henryhallam/quickie-battpacks/bms_v1_bom.xlsx

Reference Designator | Quantity | Description/Value | Manufacturer Part Number (MPN)
REF**,REF**,REF**,REF**,REF**,REF**,REF** | 7 | Fiducials | DNP
C501,C301,C401,C601,C701,C801,C901,C1001,C1101,C1201,C1301,C1401,C201,C1501,C1601,C1701,C1801,C1901,C2001,C2101,C2201,C2301,C2401,C2501,C2601,C2701 | 26 | CAP CER 0.01uF 50V | GCM155R71H103KA55D
C202,C205,C208,C1502,C1505,C1508 | 6 | CAP CER 1uF 16V | GCM188R71C105KA64D
C203,C204,C1503,C1504 | 4 | CAP CER 0.1uF 250V | CGA4J3X7T2E104M125AE
J201,J202,J1501,J1502 | 4 | Conn Picoblade 2pos | 53261-0271
Q201,Q1501 | 2 | Transistor NPN | NSV1C201MZ4
Q301,Q401,Q501,Q601,Q701,Q801,Q901,Q1001,Q1101,Q1201,Q1301,Q1401,Q1601,Q1701,Q1801,Q1901,Q2001,Q2101,Q2201,Q2301,Q2401,Q2501,Q2601,Q2701 | 24 | MOSFET P-CH 3A | DMP3130LQ
R202,R203,R1502,R1503 | 4 | RES 100R 1% | ERJ-3EKF1000V
R205,R206,R1505,R1506 | 4 | RES 120R 1% | ERJ-3EKF1200V
R301,R401,R501,R601,R701,R801,R901,R1001,R1101,R1201,R1301,R1401,R1601,R1701,R1801,R1901,R2001,R2101,R2201,R2301,R2401,R2501,R2601,R2701 | 24 | RES 10R 5% 3W | 352210RJT
T201,T1501 | 2 | Transformer pulse | HX0068ANL
U201,U1501 | 2 | IC MONITOR BATT STACK | LTC6804HG-1
P201,P301,P401,P501,P601,P701,P801,P901,P1001,P1101,P1201,P1301,P1401,P1501,P1601,P1701,P1801,P1901,P2001,P2101,P2201,P2301,P2401,P2501,P2601,P2701 | 26 | Solder point | DNP
C206,C207,C1506,C1507 | 4 | CAP CER 100pF 50V | CGJ2B2C0G1H101J050BA
R204,R1504 | 2 | RES 1.2K 1% | ERJ-2RKF1201X
R207,R208,R210,R211,R212,R213,R214,R1507,R1508,R1510,R1511,R1512,R1513,R1514 | 14 | RES 10K 0.1% | ERA-2AEB103X
R302,R402,R502,R602,R702,R802,R902,R1002,R1102,R1202,R1302,R1402,R201,R1501,R1602,R1702,R1802,R1902,R2002,R2102,R2202,R2302,R2402,R2502,R2602,R2702 | 26 | RES 100R 1% | ERJ-2RKF1000X
R209,R303,R403,R503,R603,R703,R803,R903,R1003,R1103,R1203,R1303,R1403,R1509,R1603,R1703,R1803,R1903,R2003,R2103,R2203,R2303,R2403,R2503,R2603,R2703 | 24 | RES 2.8K 1% | ERJ-2RKF2801X
D201,D1501 | 2 | DIODE GEN PURP SOD523 | 1N4148X
LED201,LED202,LED1501,LED1502 | 4 | LED 0402 YEL/GRN | SML-P12MTT86R
TH201,TH202,TH203,TH204,TH205,TH1501,TH1502,TH1503,TH1504,TH1505 | 10 | Thermistors | DNP
