henryhallam/quickie-battpacks/bms.kicad_pcb

## KiCad design bms.kicad_pcb (2017-09-25)

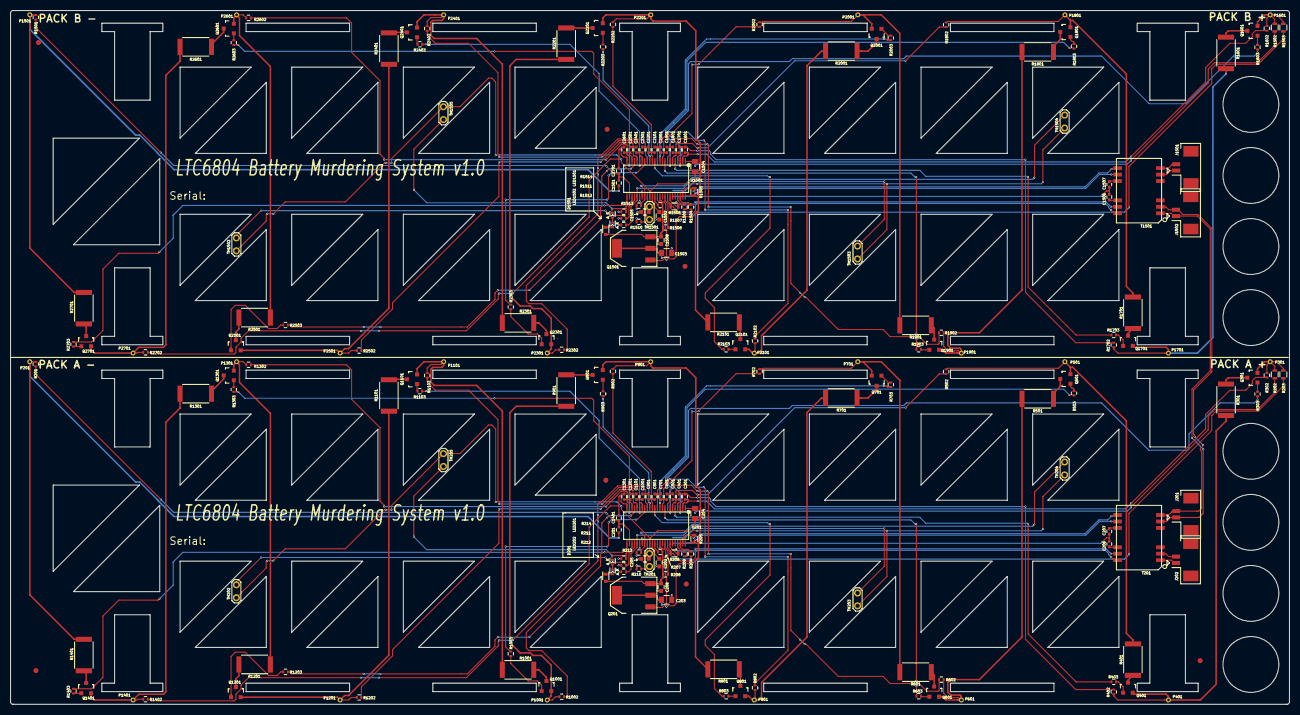
[picture p1: board bms.kicad_pcb from above]

Board: 2 copper layers, 252.0 x 136.7 mm, 216 parts (0 on the bottom side), 176 nets.

Parts:
C201, C301, C401, C501, C601, C701, C801, C901, C1001, C1101, C1201, C1301, C1401, C1501, C1601, C1701, C1801, C1901, C2001, C2101, C2201, C2301, C2401, C2501, C2601, C2701: 10nF 16V; C_0402
C202, C205, C208, C1502, C1505, C1508: 1uF 16V; C_0603
C203, C204, C1503, C1504: 0.1uF 100V; C_0805
C206, C207, C1506, C1507: 100pF; C_0402
D201, D1501: 1N4148X; SOD-523
J201, J202, J1501, J1502: CONN_01X02; Molex_PicoBlade_53261-0271
LED201, LED202, LED1501, LED1502: SML-P12MTT86R; LED_0402
P201, P301, P401, P501, P601, P701, P801, P901, P1001, P1101, P1201, P1301, P1401, P1501, P1601, P1701, P1801, P1901, P2001, P2101, P2201, P2301, P2401, P2501, P2601, P2701: CONN_01X01; Solder_Point_Round-TH_0.5mm
Q201, Q1501: NSV1C201MZ4; SOT-223
Q301, Q401, Q501, Q601, Q701, Q801, Q901, Q1001, Q1101, Q1201, Q1301, Q1401, Q1601, Q1701, Q1801, Q1901, Q2001, Q2101, Q2201, Q2301, Q2401, Q2501, Q2601, Q2701: DMP3130LQ; SOT-23
R201, R302, R402, R502, R602, R702, R802, R902, R1002, R1102, R1202, R1302, R1402, R1501, R1602, R1702, R1802, R1902, R2002, R2102, R2202, R2302, R2402, R2502, R2602, R2702: 100; R_0402
R202, R203, R1502, R1503: 100; R_0603
R204, R1504: 1.2k; R_0402
R205, R206, R1505, R1506: 120; R_0603
R207, R208, R210, R211, R212, R213, R214, R1507, R1508, R1510, R1511, R1512, R1513, R1514: 10k; R_0402
R209, R1509: 2.8k; R_0402
R301, R401, R501, R601, R701, R801, R901, R1001, R1101, R1201, R1301, R1401, R1601, R1701, R1801, R1901, R2001, R2101, R2201, R2301, R2401, R2501, R2601, R2701: 10; R_2512
R303, R403, R503, R603, R703, R803, R903, R1003, R1103, R1203, R1303, R1403, R1603, R1703, R1803, R1903, R2003, R2103, R2203, R2303, R2403, R2503, R2603, R2703: 3.3k; R_0402
T201, T1501: HX0068ANL
TH201, TH202, TH203, TH204, TH205, TH1501, TH1502, TH1503, TH1504, TH1505: THERMISTOR; Test_Point_2Pads
U201, U1501: LTC6804-1; G-SSOP-48

Connections:
/PackA/C0: C201.2, C1401.2, R201.2, U201.26
/PackA/C1: C1301.2, C1401.1, R1402.1, U201.24
/PackA/C2: C1201.2, C1301.1, R1302.1, U201.22
/PackA/C3: C1101.2, C1201.1, R1202.1, U201.20
/PackA/C4: C1001.2, C1101.1, R1102.1, U201.18
/PackA/C5: C901.2, C1001.1, R1002.1, U201.16
/PackA/C6: C801.2, C901.1, R902.1, U201.14
/PackA/C7: C701.2, C801.1, R802.1, U201.12
/PackA/C8: C601.2, C701.1, R702.1, U201.10
/PackA/C9: C501.2, C601.1, R602.1, U201.8
/PackA/C10: C401.2, C501.1, R502.1, U201.6
/PackA/C11: C301.2, C401.1, R402.1, U201.4
/PackA/C12: C301.1, R302.1, U201.2
/PackA/Cell1/Cell+: P1401.1, Q1401.2, R1301.2, R1402.2
/PackA/Cell1/DISCH': Q1401.3, R1401.1
/PackA/Cell2/Cell+: P1301.1, Q1301.2, R1201.2, R1302.2
/PackA/Cell2/DISCH': Q1301.3, R1301.1
/PackA/Cell3/Cell+: P1201.1, Q1201.2, R1101.2, R1202.2
/PackA/Cell3/DISCH': Q1201.3, R1201.1
/PackA/Cell4/Cell+: P1101.1, Q1101.2, R1001.2, R1102.2
/PackA/Cell4/DISCH': Q1101.3, R1101.1
/PackA/Cell5/Cell+: P1001.1, Q1001.2, R901.2, R1002.2
/PackA/Cell5/DISCH': Q1001.3, R1001.1
/PackA/Cell6/Cell+: P901.1, Q901.2, R801.2, R902.2
/PackA/Cell6/DISCH': Q901.3, R901.1
/PackA/Cell7/Cell+: P801.1, Q801.2, R701.2, R802.2
/PackA/Cell7/DISCH': Q801.3, R801.1
/PackA/Cell8/Cell+: P701.1, Q701.2, R601.2, R702.2
/PackA/Cell8/DISCH': Q701.3, R701.1
/PackA/Cell9/Cell+: P601.1, Q601.2, R501.2, R602.2
/PackA/Cell9/DISCH': Q601.3, R601.1
/PackA/Cell10/Cell+: P501.1, Q501.2, R401.2, R502.2
/PackA/Cell10/DISCH': Q501.3, R501.1
/PackA/Cell11/Cell+: P401.1, Q401.2, R301.2, R402.2
/PackA/Cell11/DISCH': Q401.3, R401.1
/PackA/Cell12/DISCH': Q301.3, R301.1
/PackA/DRIVE: Q201.1, U201.38
/PackA/Pack+: P301.1, Q301.2, R202.2, R203.2, R302.2
/PackA/S1: R1403.1, U201.25
/PackA/S2: R1303.1, U201.23
/PackA/S3: R1203.1, U201.21
/PackA/S4: R1103.1, U201.19
/PackA/S5: R1003.1, U201.17
/PackA/S6: R903.1, U201.15
/PackA/S7: R803.1, U201.13
/PackA/S8: R703.1, U201.11
/PackA/S9: R603.1, U201.9
/PackA/S10: R503.1, U201.7
/PackA/S11: R403.1, U201.5
/PackA/S12: R303.1, U201.3
/PackA/TEMP1: LED201.1, R214.2, TH205.2, U201.27
/PackA/TEMP2: R211.2, TH202.2, U201.28
/PackA/TEMP3: R212.2, TH203.2, U201.29
/PackA/TEMP4: R213.2, TH204.2, U201.32
/PackA/TEMP5: R210.2, TH201.2, U201.33
/PackA/V+: C204.1, R202.1, U201.1
/PackA/V-: C201.1, C202.2, C203.2, C204.2, C205.2, C206.2, C207.2, C208.2, P201.1, R201.1, R204.2, R210.1, R211.1, R212.1, R213.1, R214.1, R1401.2, U201.30, U201.31
/PackA/VREF1: C202.1, U201.35
/PackA/VREF2: C205.1, TH201.1, TH202.1, TH203.1, TH204.1, TH205.1, U201.34
/PackA/VREG: C208.1, D201.2, Q201.3, R207.2, R208.2, U201.37
/PackA/isoSPIA+: J202.1, T201.1
/PackA/isoSPIA-: J202.2, T201.2
/PackB/C0: C1501.2, C2701.2, R1501.2, U1501.26
/PackB/C1: C2601.2, C2701.1, R2702.1, U1501.24
/PackB/C2: C2501.2, C2601.1, R2602.1, U1501.22
/PackB/C3: C2401.2, C2501.1, R2502.1, U1501.20
/PackB/C4: C2301.2, C2401.1, R2402.1, U1501.18
/PackB/C5: C2201.2, C2301.1, R2302.1, U1501.16
/PackB/C6: C2101.2, C2201.1, R2202.1, U1501.14
/PackB/C7: C2001.2, C2101.1, R2102.1, U1501.12
/PackB/C8: C1901.2, C2001.1, R2002.1, U1501.10
/PackB/C9: C1801.2, C1901.1, R1902.1, U1501.8
/PackB/C10: C1701.2, C1801.1, R1802.1, U1501.6
/PackB/C11: C1601.2, C1701.1, R1702.1, U1501.4
/PackB/C12: C1601.1, R1602.1, U1501.2
/PackB/Cell1/Cell+: P2701.1, Q2701.2, R2601.2, R2702.2
/PackB/Cell1/DISCH': Q2701.3, R2701.1
/PackB/Cell2/Cell+: P2601.1, Q2601.2, R2501.2, R2602.2
/PackB/Cell2/DISCH': Q2601.3, R2601.1
/PackB/Cell3/Cell+: P2501.1, Q2501.2, R2401.2, R2502.2
/PackB/Cell3/DISCH': Q2501.3, R2501.1
/PackB/Cell4/Cell+: P2401.1, Q2401.2, R2301.2, R2402.2
/PackB/Cell4/DISCH': Q2401.3, R2401.1
/PackB/Cell5/Cell+: P2301.1, Q2301.2, R2201.2, R2302.2
/PackB/Cell5/DISCH': Q2301.3, R2301.1
/PackB/Cell6/Cell+: P2201.1, Q2201.2, R2101.2, R2202.2
/PackB/Cell6/DISCH': Q2201.3, R2201.1
/PackB/Cell7/Cell+: P2101.1, Q2101.2, R2001.2, R2102.2
/PackB/Cell7/DISCH': Q2101.3, R2101.1
/PackB/Cell8/Cell+: P2001.1, Q2001.2, R1901.2, R2002.2
/PackB/Cell8/DISCH': Q2001.3, R2001.1
/PackB/Cell9/Cell+: P1901.1, Q1901.2, R1801.2, R1902.2
/PackB/Cell9/DISCH': Q1901.3, R1901.1
/PackB/Cell10/Cell+: P1801.1, Q1801.2, R1701.2, R1802.2
/PackB/Cell10/DISCH': Q1801.3, R1801.1
/PackB/Cell11/Cell+: P1701.1, Q1701.2, R1601.2, R1702.2
/PackB/Cell11/DISCH': Q1701.3, R1701.1
/PackB/Cell12/DISCH': Q1601.3, R1601.1
/PackB/DRIVE: Q1501.1, U1501.38
/PackB/Pack+: P1601.1, Q1601.2, R1502.2, R1503.2, R1602.2
/PackB/S1: R2703.1, U1501.25
/PackB/S2: R2603.1, U1501.23
/PackB/S3: R2503.1, U1501.21
/PackB/S4: R2403.1, U1501.19
/PackB/S5: R2303.1, U1501.17
/PackB/S6: R2203.1, U1501.15
/PackB/S7: R2103.1, U1501.13
/PackB/S8: R2003.1, U1501.11
/PackB/S9: R1903.1, U1501.9
/PackB/S10: R1803.1, U1501.7
/PackB/S11: R1703.1, U1501.5
/PackB/S12: R1603.1, U1501.3
/PackB/TEMP1: LED1501.1, R1514.2, TH1505.2, U1501.27
/PackB/TEMP2: R1511.2, TH1502.2, U1501.28
/PackB/TEMP3: R1512.2, TH1503.2, U1501.29
/PackB/TEMP4: R1513.2, TH1504.2, U1501.32
/PackB/TEMP5: R1510.2, TH1501.2, U1501.33
/PackB/V+: C1504.1, R1502.1, U1501.1
/PackB/V-: C1501.1, C1502.2, C1503.2, C1504.2, C1505.2, C1506.2, C1507.2, C1508.2, P1501.1, R1501.1, R1504.2, R1510.1, R1511.1, R1512.1, R1513.1, R1514.1, R2701.2, U1501.30, U1501.31
/PackB/VREF1: C1502.1, U1501.35
/PackB/VREF2: C1505.1, TH1501.1, TH1502.1, TH1503.1, TH1504.1, TH1505.1, U1501.34
/PackB/VREG: C1508.1, D1501.2, Q1501.3, R1507.2, R1508.2, U1501.37
/PackB/isoSPIB+: J1501.1, T1501.5
/PackB/isoSPIB-: J1501.2, T1501.6
/isoSPI_P2P_+: J201.1, J1502.1, T201.5, T1501.1
/isoSPI_P2P_-: J201.2, J1502.2, T201.6, T1501.2
unnamed: C203.1, Q201.2, Q201.4, R203.1
unnamed: C206.1, T201.10
unnamed: C207.1, T201.9
unnamed: C1503.1, Q1501.2, Q1501.4, R1503.1
unnamed: C1506.1, T1501.10
unnamed: C1507.1, T1501.9
unnamed: D201.1, LED202.2
unnamed: D1501.1, LED1502.2
unnamed: LED201.2, LED202.1
unnamed: LED1501.2, LED1502.1
unnamed: Q301.1, R303.2
unnamed: Q401.1, R403.2
unnamed: Q501.1, R503.2
unnamed: Q601.1, R603.2
unnamed: Q701.1, R703.2
unnamed: Q801.1, R803.2
unnamed: Q901.1, R903.2
unnamed: Q1001.1, R1003.2
unnamed: Q1101.1, R1103.2
unnamed: Q1201.1, R1203.2
unnamed: Q1301.1, R1303.2
unnamed: Q1401.1, R1403.2
unnamed: Q1601.1, R1603.2
unnamed: Q1701.1, R1703.2
unnamed: Q1801.1, R1803.2
unnamed: Q1901.1, R1903.2
unnamed: Q2001.1, R2003.2
unnamed: Q2101.1, R2103.2
unnamed: Q2201.1, R2203.2
unnamed: Q2301.1, R2303.2
unnamed: Q2401.1, R2403.2
unnamed: Q2501.1, R2503.2
unnamed: Q2601.1, R2603.2
unnamed: Q2701.1, R2703.2
unnamed: R204.1, R209.2, U201.46
unnamed: R205.1, T201.7, U201.47
unnamed: R205.2, T201.8, U201.48
unnamed: R206.1, T201.11, U201.41
unnamed: R206.2, T201.12, U201.42
unnamed: R207.1, U201.36
unnamed: R208.1, U201.40
unnamed: R209.1, U201.45
unnamed: R1504.1, R1509.2, U1501.46
unnamed: R1505.1, T1501.7, U1501.47
unnamed: R1505.2, T1501.8, U1501.48
unnamed: R1506.1, T1501.11, U1501.41
unnamed: R1506.2, T1501.12, U1501.42
unnamed: R1507.1, U1501.36
unnamed: R1508.1, U1501.40
unnamed: R1509.1, U1501.45
