henryhallam/quickie-battpacks/(commit log)

2017-09-25 Dual-pack version, schematic complete but not all footprints / parts assigned
    [bms.sch, cell.sch, pack.sch]
2017-09-25 Footprints assigned, some MFNs
    [cell.sch, pack.sch]
2017-09-25 ERC fixes
    [bms.sch, cell.sch, pack.sch]
2017-09-25 Netlist exported
    [bms.kicad_pcb, cell.sch, pack.sch]
2017-09-25 Board outline and slots for spacer plates
    [bms.kicad_pcb]
2017-09-25 Add access holes for screws
    [bms.kicad_pcb]
2017-09-25 Place balance wire solder points for pack A
    [bms.kicad_pcb]
2017-09-25 Change to mostly 0402 passives
    [cell.sch, pack.sch]
2017-09-25 Added missing series connections
    [bms.sch, cell.sch, pack.sch]
2017-09-25 very rough placement of cell subcircuits
    [bms.kicad_pcb]
2017-09-25 place and route filter caps
    [bms.kicad_pcb]
2017-09-25 place RC filter resistors
    [bms.kicad_pcb]
2017-09-25 placement progress
    [bms.kicad_pcb, bms.sch, cell.sch, pack.sch]
2017-09-25 Change LED and thermistors
    [bms.kicad_pcb, cell.sch, pack.sch]
2017-09-25 Approx placement complete
    [bms.kicad_pcb]
2017-09-25 routing progress
    [bms.kicad_pcb, cell.sch, pack.sch]
2017-09-25 discharge paths routed
    [bms.kicad_pcb]
2017-09-25 sense paths routed
    [bms.kicad_pcb]
2017-09-25 isospi diff pairs routed
    [bms.kicad_pcb]
2017-09-25 routuing progress
    [bms.kicad_pcb]
2017-09-25 pack A routing complete?
    [bms.kicad_pcb]
2017-09-25 pack A silkscreen
    [bms.kicad_pcb]
2017-09-25 Clone layout to pack B
    [bms.kicad_pcb]
2017-09-25 Fix trace-across-cutout
    [bms.kicad_pcb]
2017-09-25 BOM as sent to Tempo
    [bms_v1_bom.xlsx]
2017-09-25 Headnote schematic WIP
    [IsoCAN.sch, IsoSPI.sch, LV_power.sch, bms-head.sch, contactor.sch, hv_sense.sch, i_sense.sch, instaspin.sch]
2017-09-25 Headnode schematic progress; chose power supply modules
2017-09-25 Unfinished headnode
    [IsoCAN.sch, IsoSPI.sch, bms-head.sch, contactor.sch, hv_sense.sch, i_sense.sch, mcu.sch, precharge.sch]
