henryhallam/quickie-battpacks/(notices)

Notices in the files:
headnode/mcu.sch:
License: CC-BY-SA V4.0
headnode/IsoSPI.sch:
Released under CERN OHL v1.2
